GBhack/UofAmechatronics/Documentation/sources/includes/titlepage.tex

\begin{titlepage}

\newcommand{\HRule}{\rule{\linewidth}{0.5mm}} % Defines a new command for the horizontal lines, change thickness here

\center % Center everything on the page
 
%----------------------------------------------------------------------------------------
%   HEADING SECTIONS
%----------------------------------------------------------------------------------------

\textsc{\LARGE University of Arizona}\\[1.5cm] % Name of your university/college
\textsc{\Large Mechatronics Class}\\[0.5cm] % Major heading such as course name
\textsc{\large Embedded Accelerometer Project}\\[0.5cm] % Minor heading such as course title

%----------------------------------------------------------------------------------------
%   TITLE SECTION
%----------------------------------------------------------------------------------------

\HRule \\[0.4cm]
{ \huge \bfseries Project Documentation}\\[0.4cm] % Title of your document
{ \Large \bfseries Project Management}\\[0.4cm] % Title of your document
\HRule \\[1.5cm]

%----------------------------------------------------------------------------------------
%   DATE SECTION
%----------------------------------------------------------------------------------------

{\large \today}\\[1.5cm] % Date, change the \today to a set date if you want to be precise

%----------------------------------------------------------------------------------------
%   AUTHOR SECTION
%----------------------------------------------------------------------------------------
\large\emph{Authors:}\\
Adrien \textsc{Bouskela}\small (adrien.bouskela@ipsa.fr)\\
Gregory \textsc{Largange}\small (gregory.largange@ipsa.fr)\\
Guillaume \textsc{Biton} \small (guillaume.biton@ipsa.fr)\\[1cm]

\large\emph{Mentors:}\\
Zoltan \textsc{Szabo}\small (zoltanszabo@email.arizona.edu)\\
\textsc{Dr. Enikov}\small (enikov@email.arizona.edu)\\[1.5cm]

%----------------------------------------------------------------------------------------
%   LOGO SECTION
%----------------------------------------------------------------------------------------

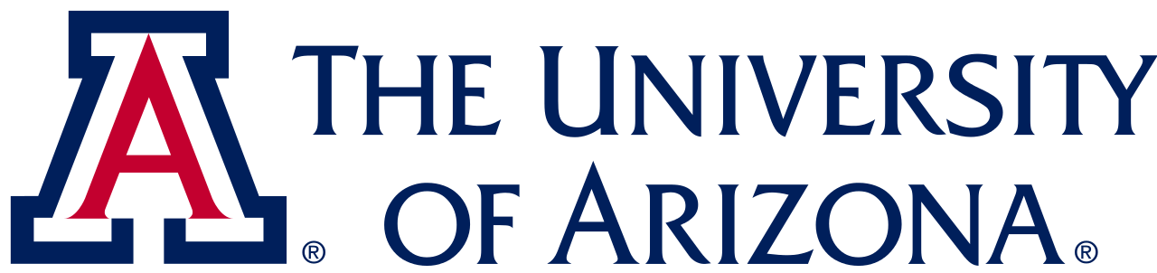
[picture p1: Documentation/sources/Graphics/logo.png]
\\[1cm] % Include a department/university logo - this will require the graphicx package
 
%----------------------------------------------------------------------------------------

\vfill % Fill the rest of the page with whitespace

\end{titlepage}
