GBhack/UofAmechatronics/Documentation/Processing.pdf

# Table of Contents

plot of each element per axis ( the first plot will be Accx ,VX , and Xx,the second one is Accy ,

----Error in Data transmission----Error occured at line 3

# Representations of Acceleration , velocity and position in different plots

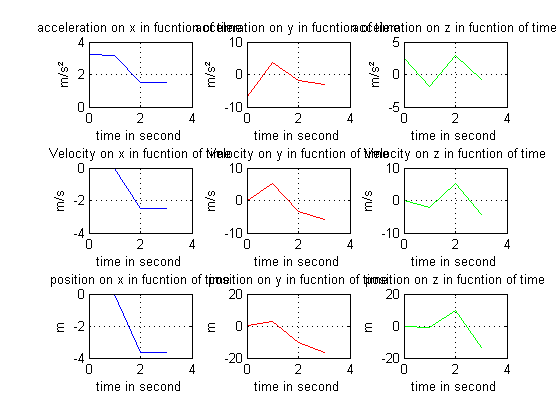
[picture p13: figure]

# Dimensional plot

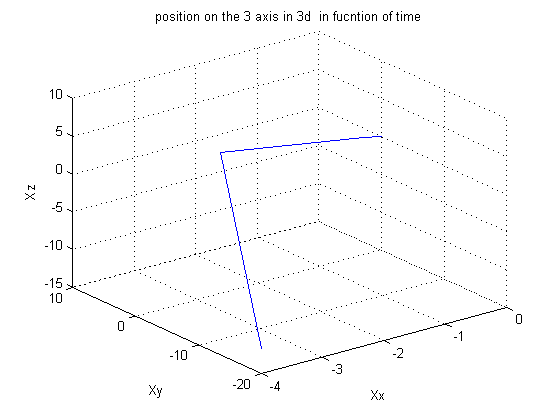
[picture p14: figure]

# plot of each element per axis ( the first plot will

be Accx ,VX , and Xx,the second one is Accy ,

# Vy , Xy )

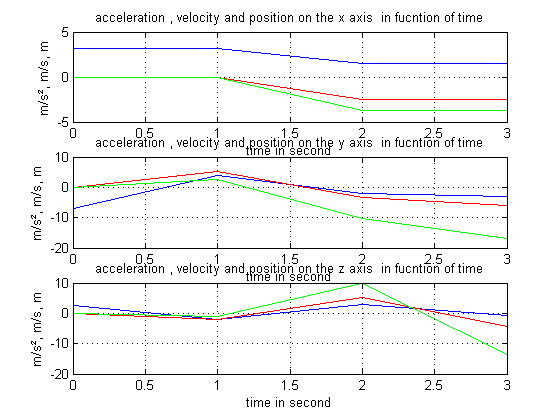
[picture p15: figure]

# Plot of each element in one figure

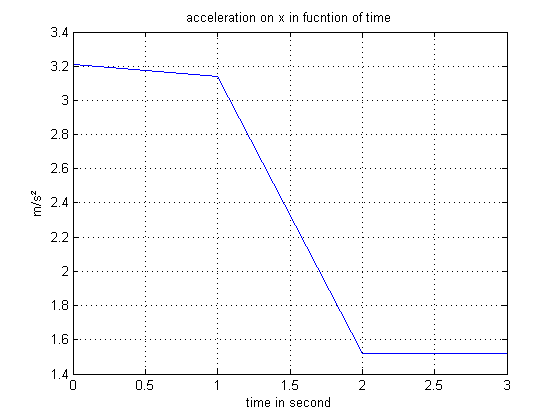
[picture p16: figure]
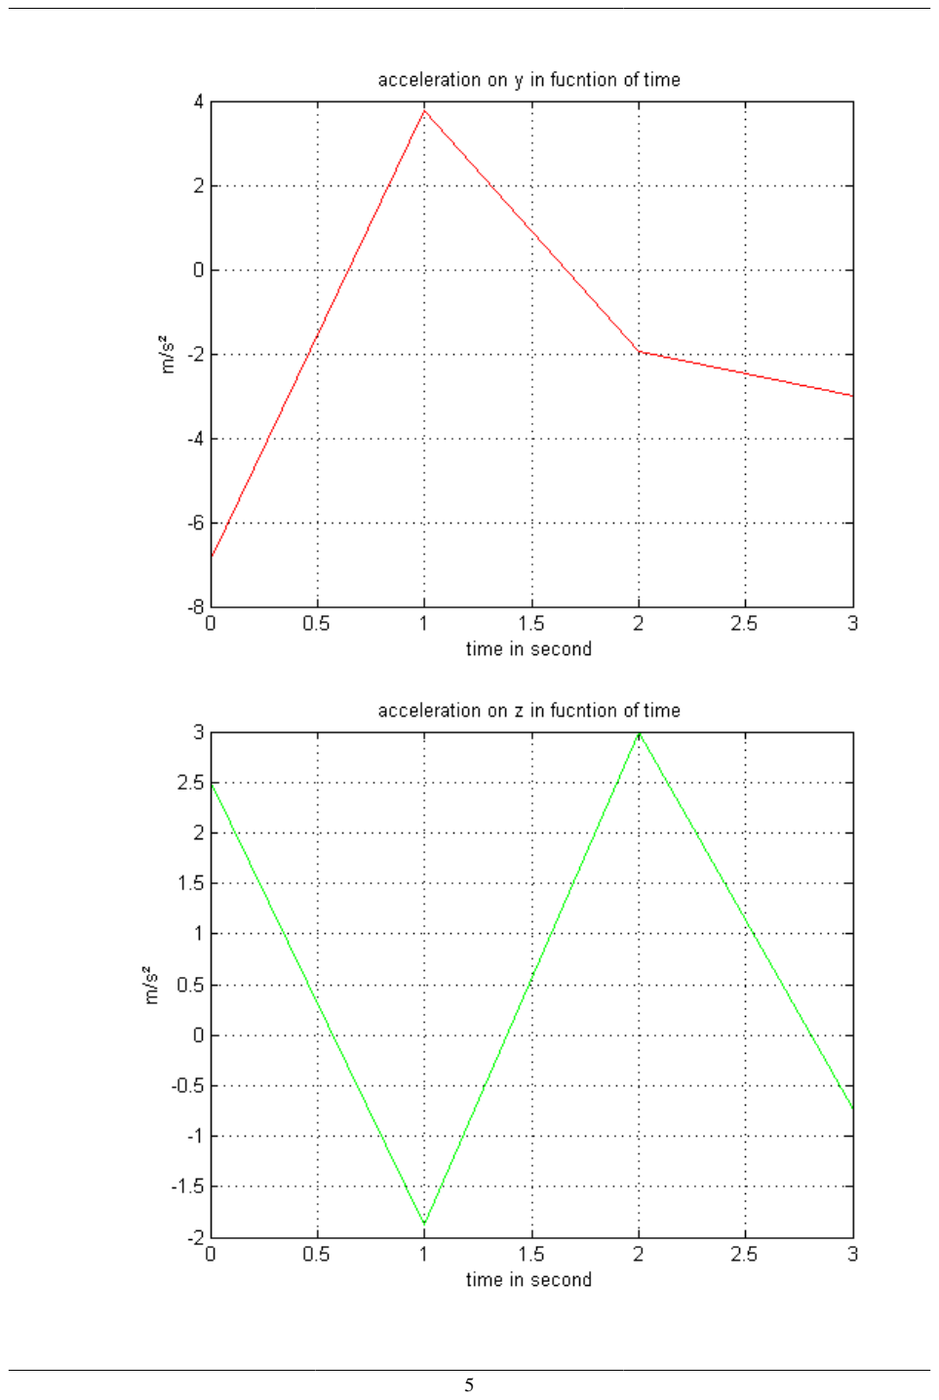
[picture p17: page 5]
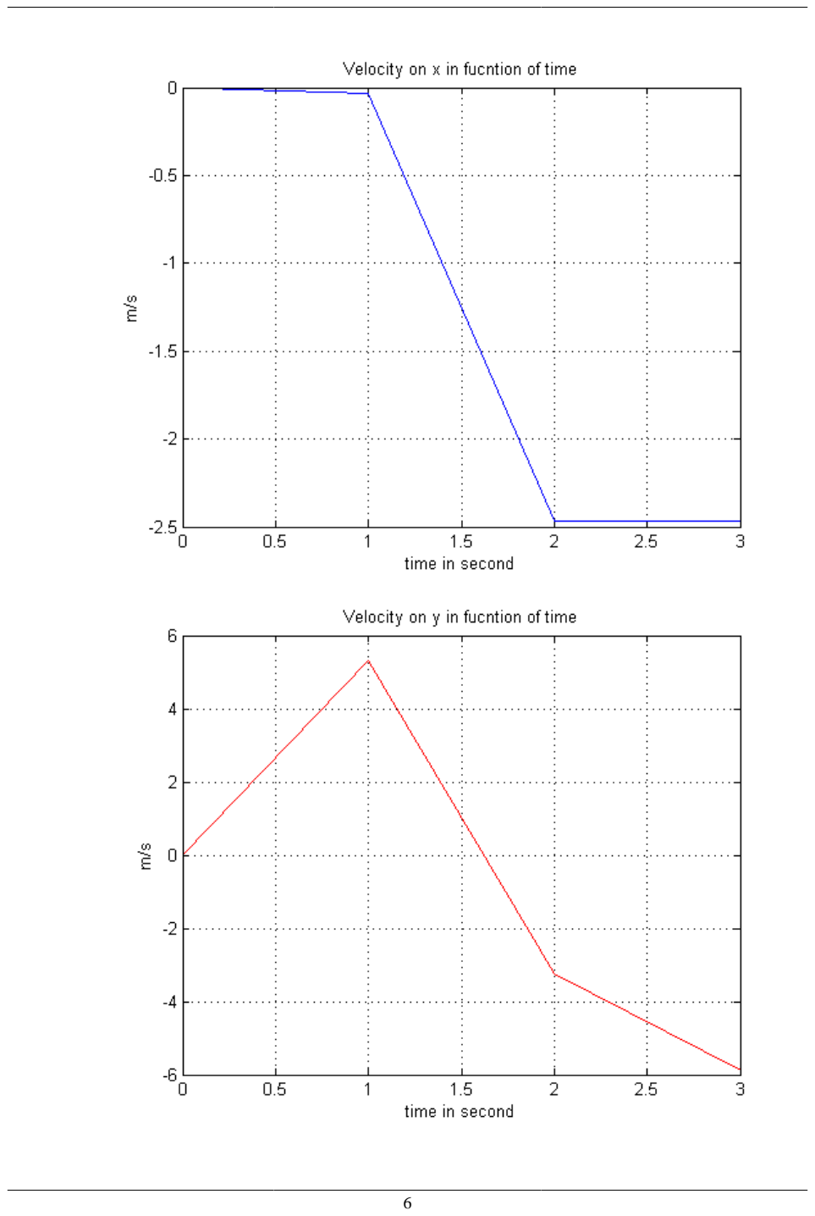
[picture p18: page 6]
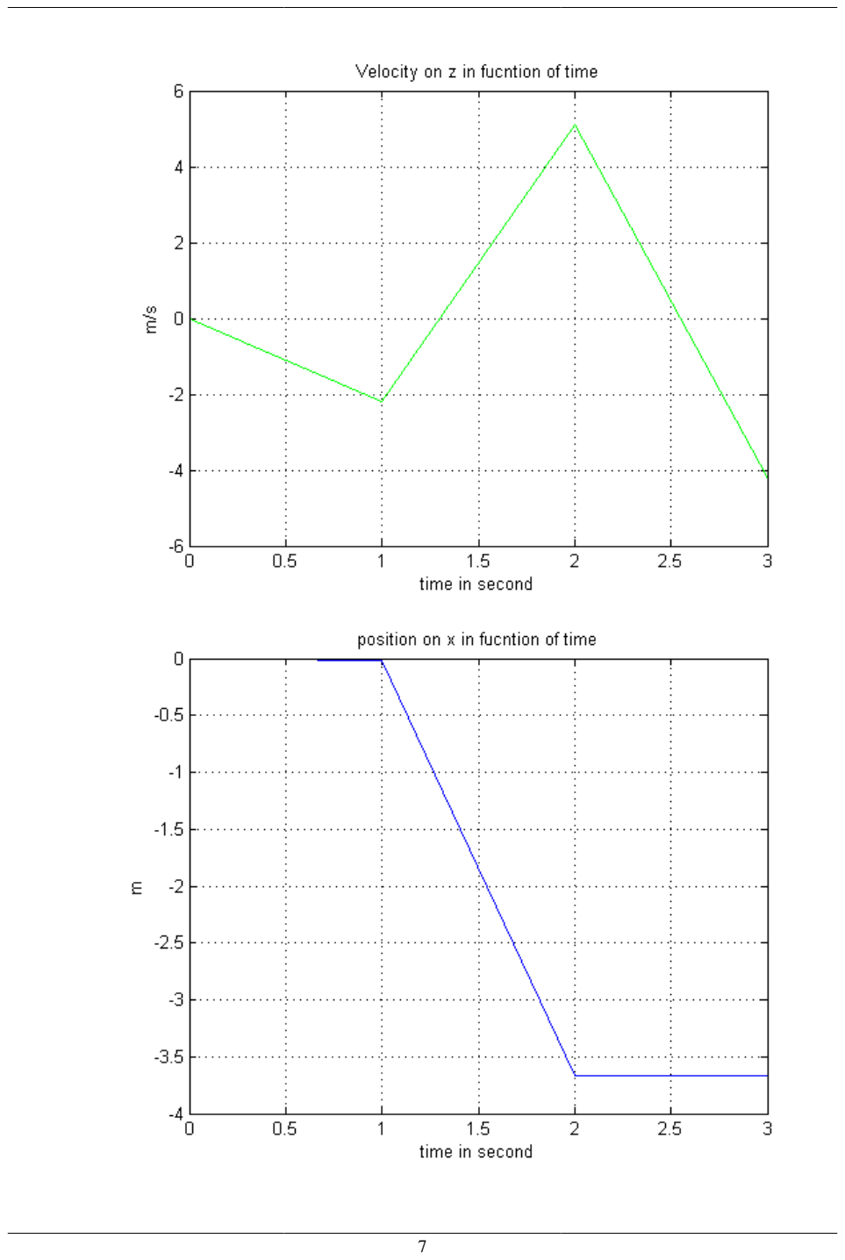
[picture p19: page 7]
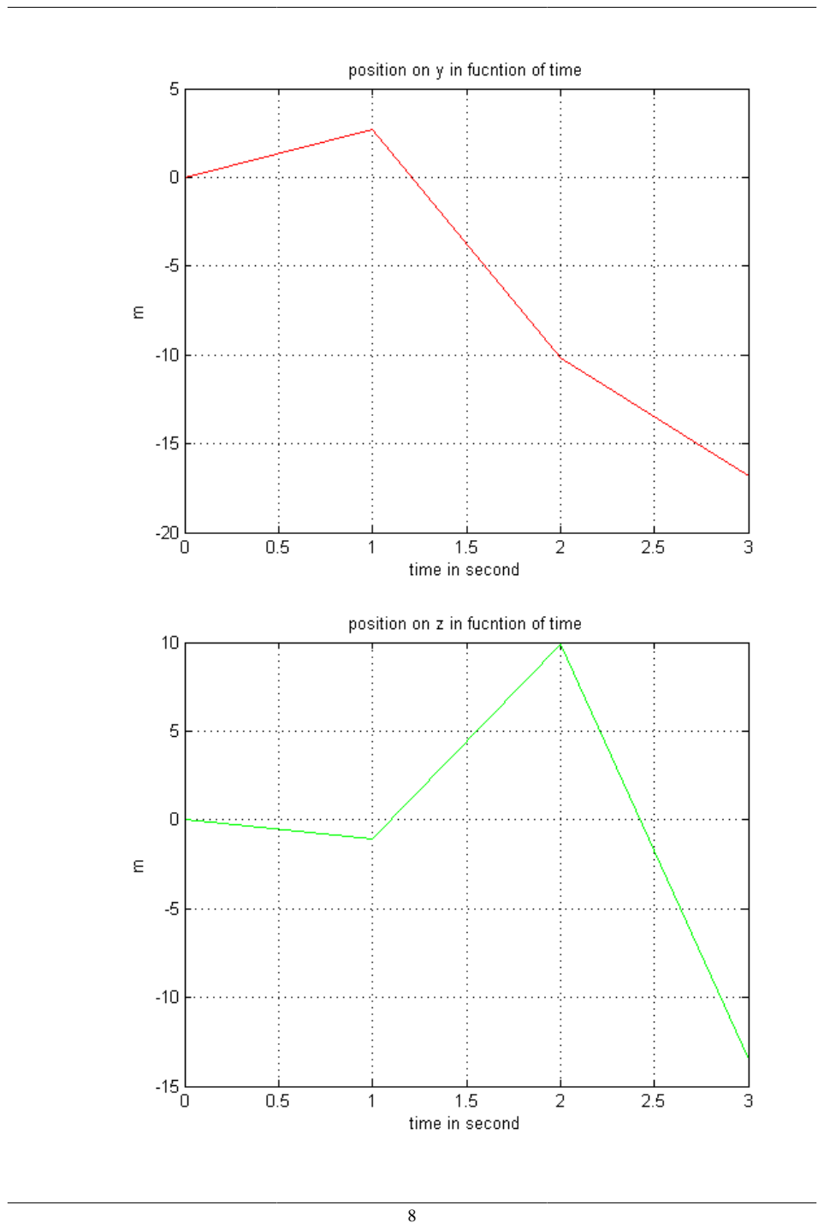
[picture p20: page 8]

Published with MATLAB® 7.14
