GBhack/UofAmechatronics/Documentation/sources/Graphics/googleSheet.png

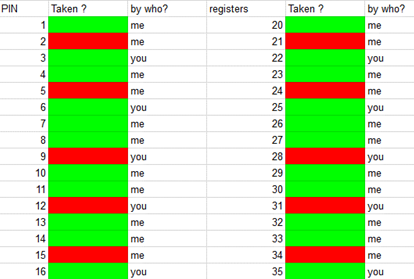
Documentation/sources/Graphics/googleSheet.png
