GBhack/UofAmechatronics/Documentation/sources/Graphics/GS_GPR.png

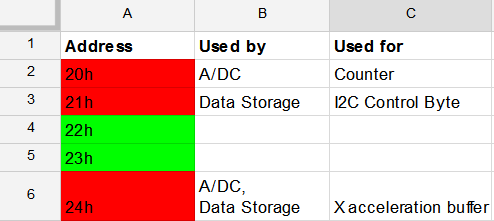
Documentation/sources/Graphics/GS_GPR.png
