GBhack/UofAmechatronics/Documentation/sources/Graphics/Schematic.png

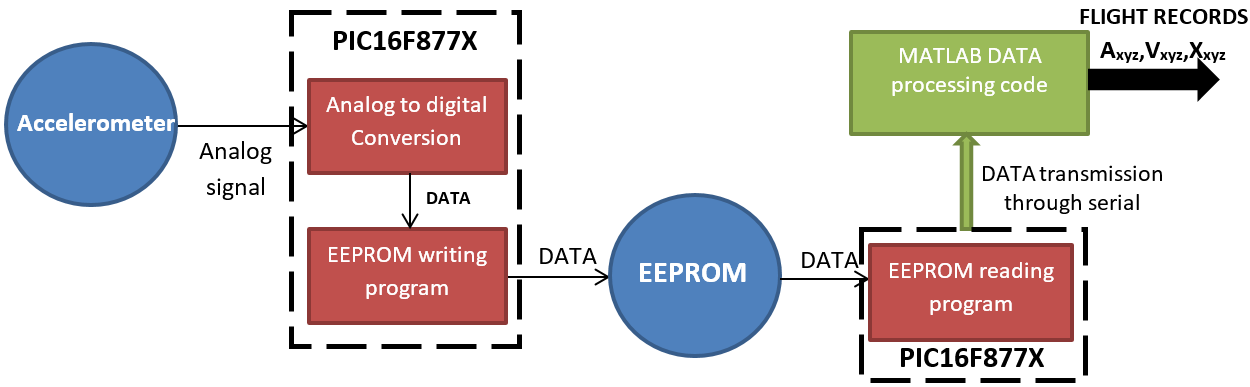
Documentation/sources/Graphics/Schematic.png
