GBhack/UofAmechatronics/Documentation/sources/Graphics/SM_5.png

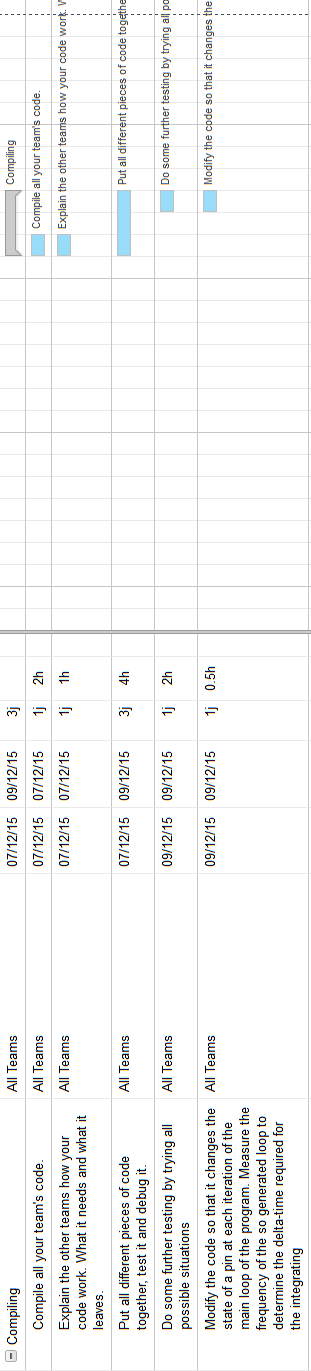
Documentation/sources/Graphics/SM_5.png
