GBhack/UofAmechatronics/Schematics/Data Recovery.pdf

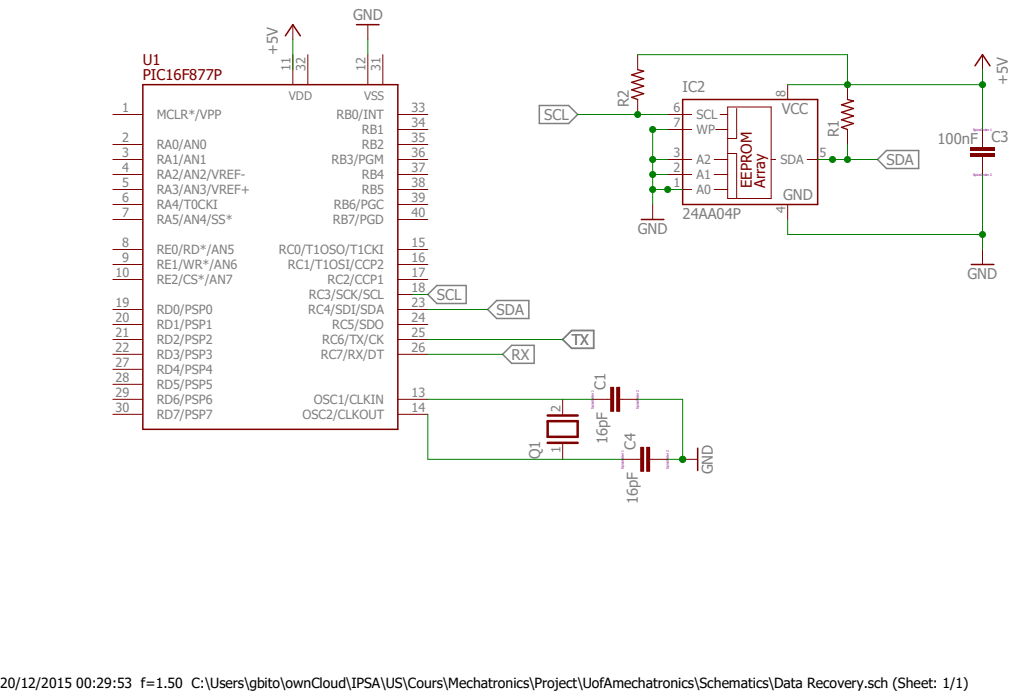
[picture p25: page 1]
20/12/2015 00:29:53 f=1.50 C:\Users\gbito\ownCloud\IPSA\US\Cours\Mechatronics\Project\UofAmechatronics\Schematics\Data Recovery.sch (Sheet: 1/1) SpiceOrder 1; SpiceOrder 2; SpiceOrder 1 SpiceOrder 2 SpiceOrder 1; GND ⁺⁵V; GND; SCL 6; SDA; VDD; VSS; RA0/AN0 2 RA1/AN1 3 RA2/AN2/VREF- 4 RA3/AN3/VREF+ 5 RA4/T0CKI 6 RA5/AN4/SS* 7; RB0/INT; RB3/PGM; RB6/PGC; RB7/PGD; RC0/T1OSO/T1CKI; RC1/T1OSI/CCP2; RC2/CCP1; RC3/SCK/SCL; RC4/SDI/SDA; RC5/SDO; 26 ¹¹³²1231; RD2/PSP2 21 RD3/PSP3 22 RD4/PSP4 27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

GND ⁺⁵V GND
VCC
SDA
GND
