GBhack/UofAmechatronics/Schematics/Embedded.pdf

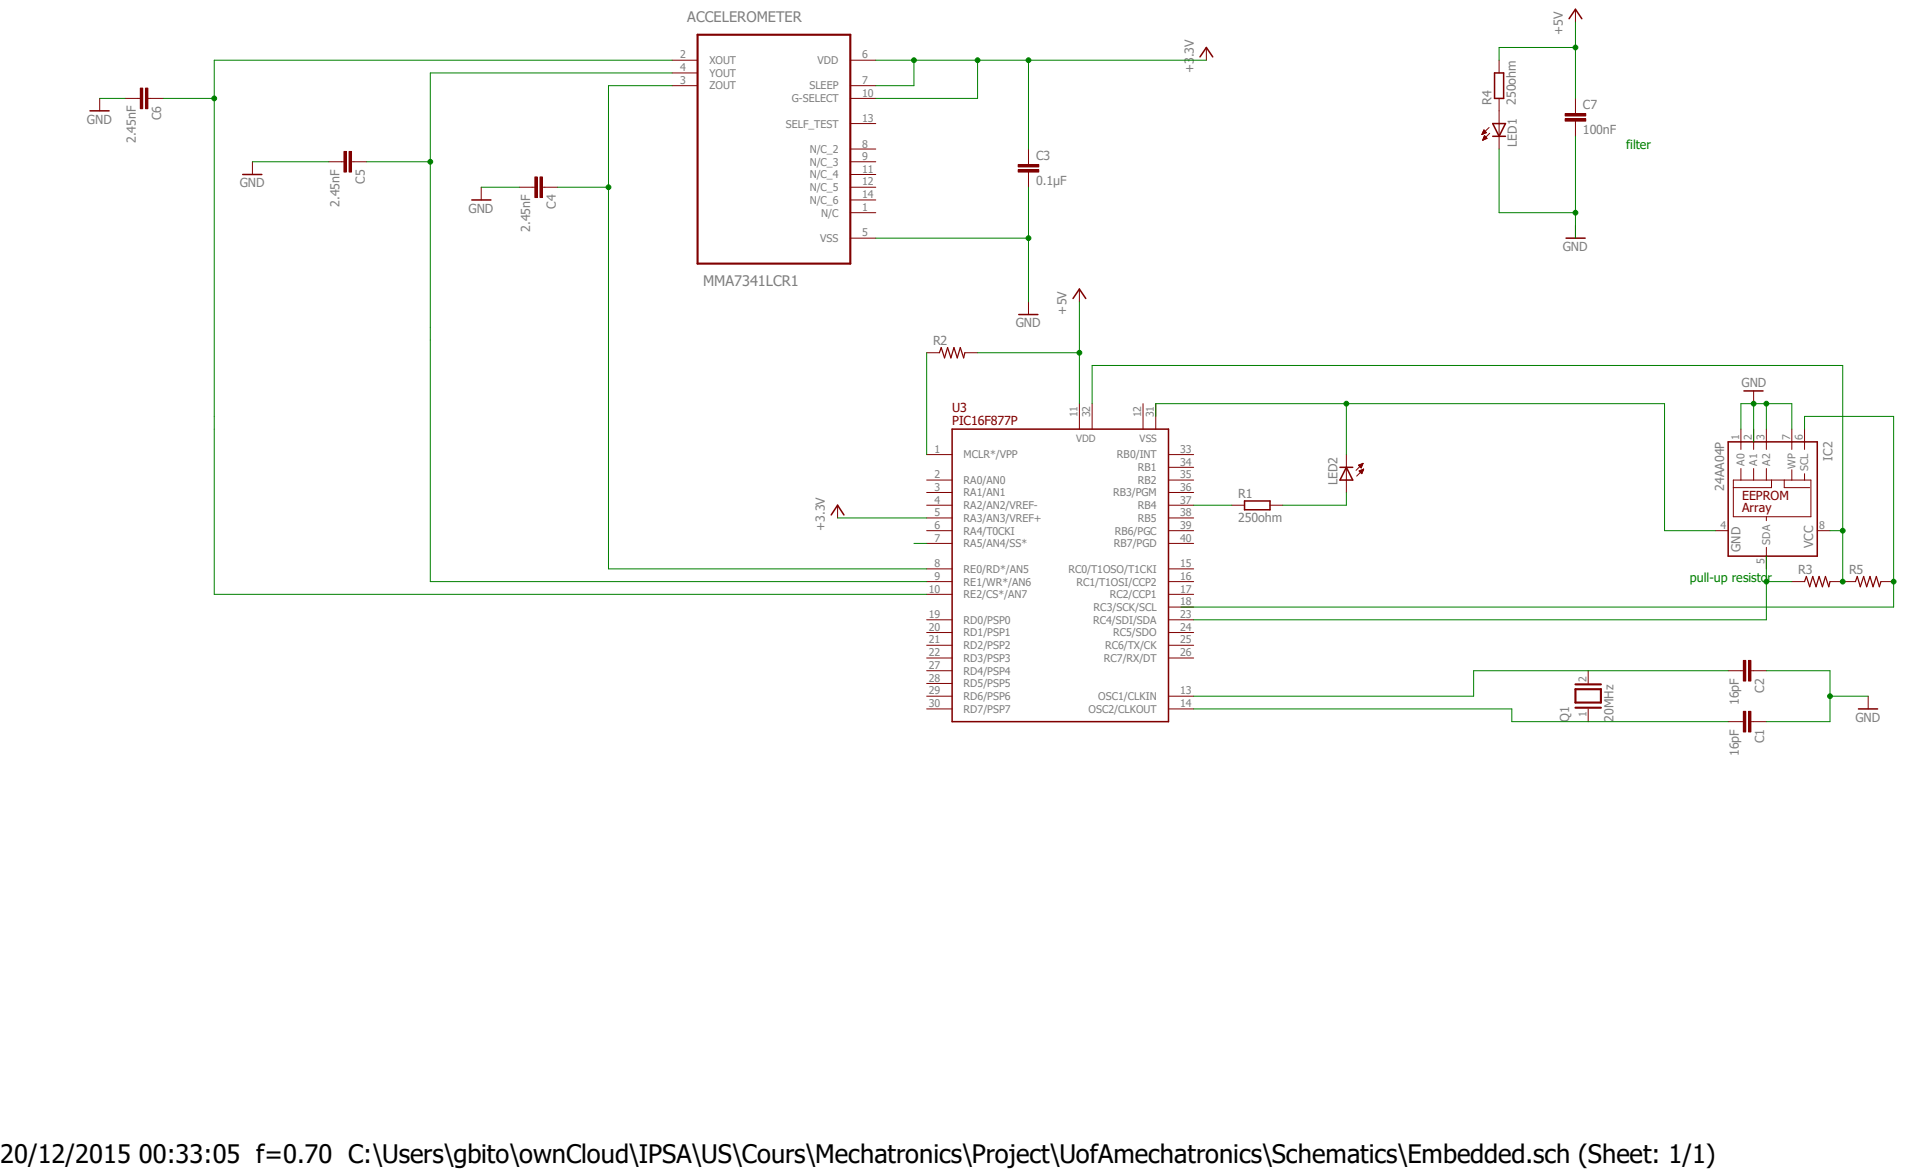
[picture p26: page 1]

20/12/2015 00:33:05 f=0.70 C:\Users\gbito\ownCloud\IPSA\US\Cours\Mechatronics\Project\UofAmechatronics\Schematics\Embedded.sch (Sheet: 1/1) ²⁴AA⁰⁴P
