GBhack/UofAmechatronics/Schematics/Data Recovery.sch

## EAGLE design Schematics/Data Recovery.sch (2015-12-20)

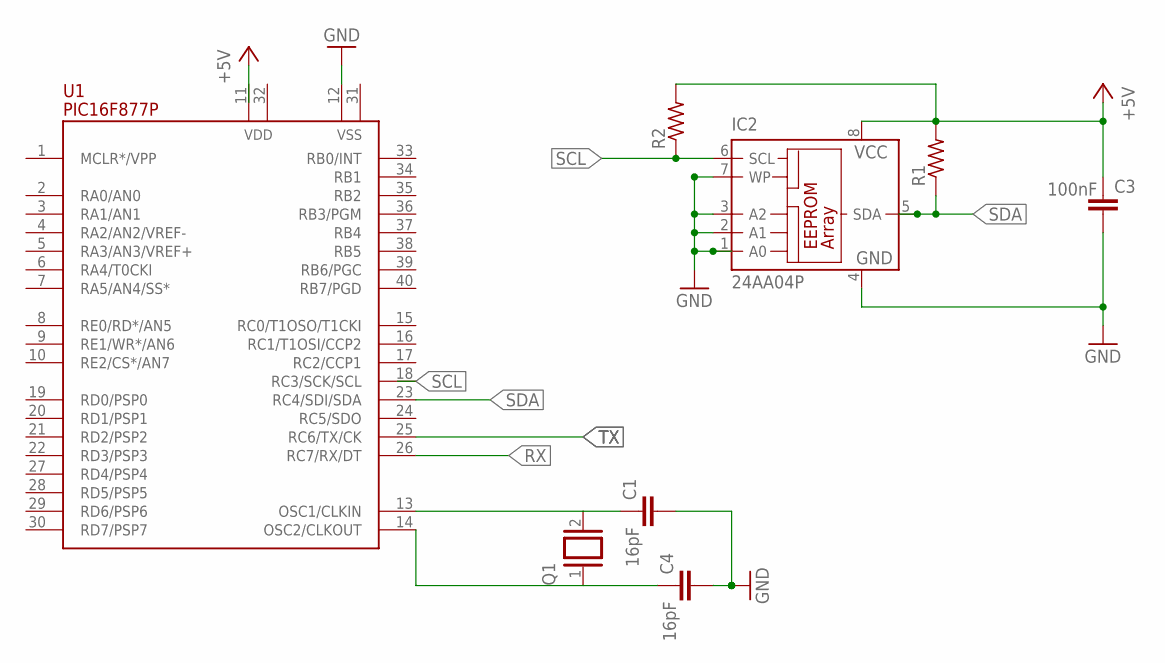
[picture p27: schematic Data Recovery.sch]

Parts:
C1, C3, C4: C; C0805
IC2: 24AA04P; DIL8
Q1: XTAL; Q
R1, R2: R-US_0204/2V; 0204V
U1: PIC16F877P; DIL40

Connections:
+5V: C3.1, IC2.8 (VCC), R1.2, R2.2
GND: C1.2, C3.2, C4.2, IC2.1 (A0), IC2.2 (A1), IC2.3 (A2), IC2.4 (GND), IC2.7 (WP), U1.12 (VSS)
unnamed: C1.1, Q1.2, U1.13 (OSC1/CLKIN)
unnamed: C4.1, Q1.1, U1.14 (OSC2/CLKOUT)
RX: U1.26 (RC7/RX/DT)
SCL: IC2.6 (SCL), R2.1
SDA: IC2.5 (SDA), R1.1, U1.23 (RC4/SDI/SDA)
TX: U1.25 (RC6/TX/CK)
