GBhack/UofAmechatronics/Schematics/Embedded.sch

## EAGLE design Schematics/Embedded.sch (2015-12-20)

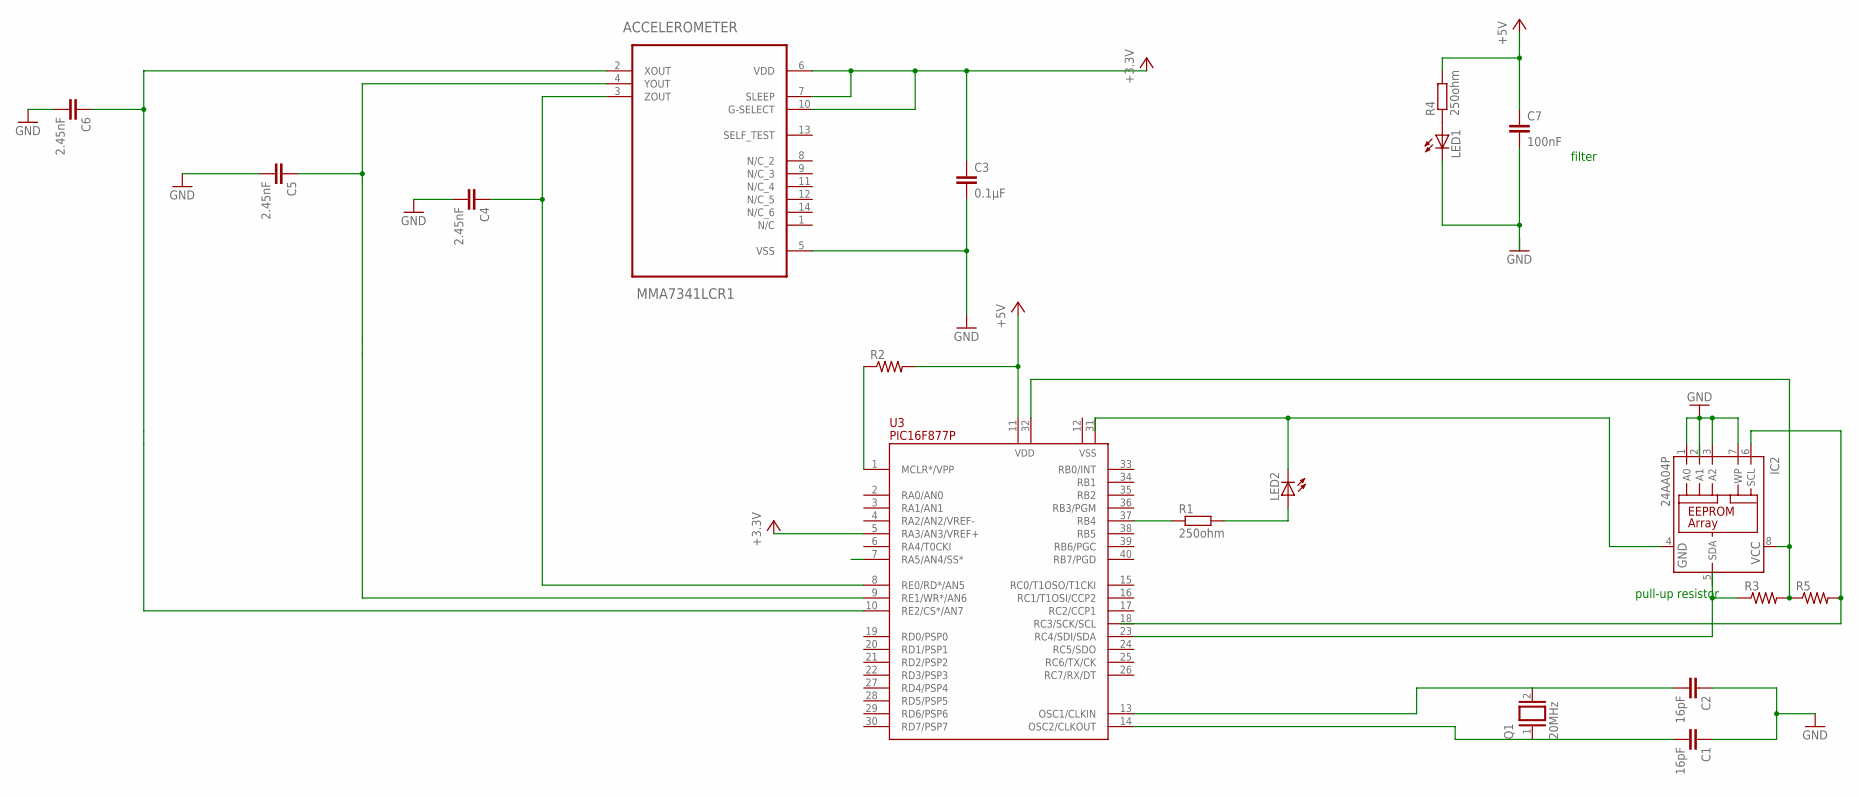
[picture p28: schematic Embedded.sch]

Parts:
ACCELEROMETER: MMA7341LCR1; LGA14R80P1X6_500X300X100
C1, C2: 16pF; C5B2.5
C3: 0.1µF; C5B2.5
C4, C5, C6: 2.45nF; C5B2.5
C7: 100nF; C5B2.5
IC2: 24AA04P; DIL8
LED1: LAP4-BOTTOM; P47F-BOTTOM
LED2: LAW51M; W51
Q1: 20MHz; QS
R1, R4: 250ohm; 0204/7
R2, R3, R5: R-US_0204/2V; 0204V
U3: PIC16F877P; DIL40

Connections:
+5V: ACCELEROMETER.6 (VDD), ACCELEROMETER.7 (SLEEP), ACCELEROMETER.10 (G-SELECT), C3.1, C7.1, R2.2, R4.2, U3.5 (RA3/AN3/VREF+), U3.11 (VDD)
GND: ACCELEROMETER.5 (VSS), C1.1, C2.1, C3.2, C4.2, C5.2, C6.2, IC2.1 (A0), IC2.3 (A2), IC2.7 (WP)
unnamed: R3.1, U3.23 (RC4/SDI/SDA)
unnamed: IC2.6 (SCL), R5.2
unnamed: C2.2, Q1.2, U3.13 (OSC1/CLKIN)
unnamed: C1.2, Q1.1, U3.14 (OSC2/CLKOUT)
unnamed: C7.2, LED1.C
unnamed: R2.1, U3.1 (MCLR*/VPP)
unnamed: R1.1, U3.37 (RB4)
unnamed: IC2.8 (VCC), R3.2, R5.1, U3.32 (VDD)
unnamed: LED2.A, R1.2
unnamed: LED1.A, R4.1
unnamed: IC2.4 (GND), LED2.C
unnamed: ACCELEROMETER.3 (ZOUT), C4.1, U3.8 (RE0/RD*/AN5)
unnamed: ACCELEROMETER.4 (YOUT), C5.1, U3.9 (RE1/WR*/AN6)
unnamed: ACCELEROMETER.2 (XOUT), C6.1, U3.10 (RE2/CS*/AN7)

Notes on the sheet:
pull-up resistor
filter
